Kev1n8088/CRVFCU/CRVFCU.kicad_pcb

## KiCad design CRVFCU.kicad_pcb (2025-06-09)

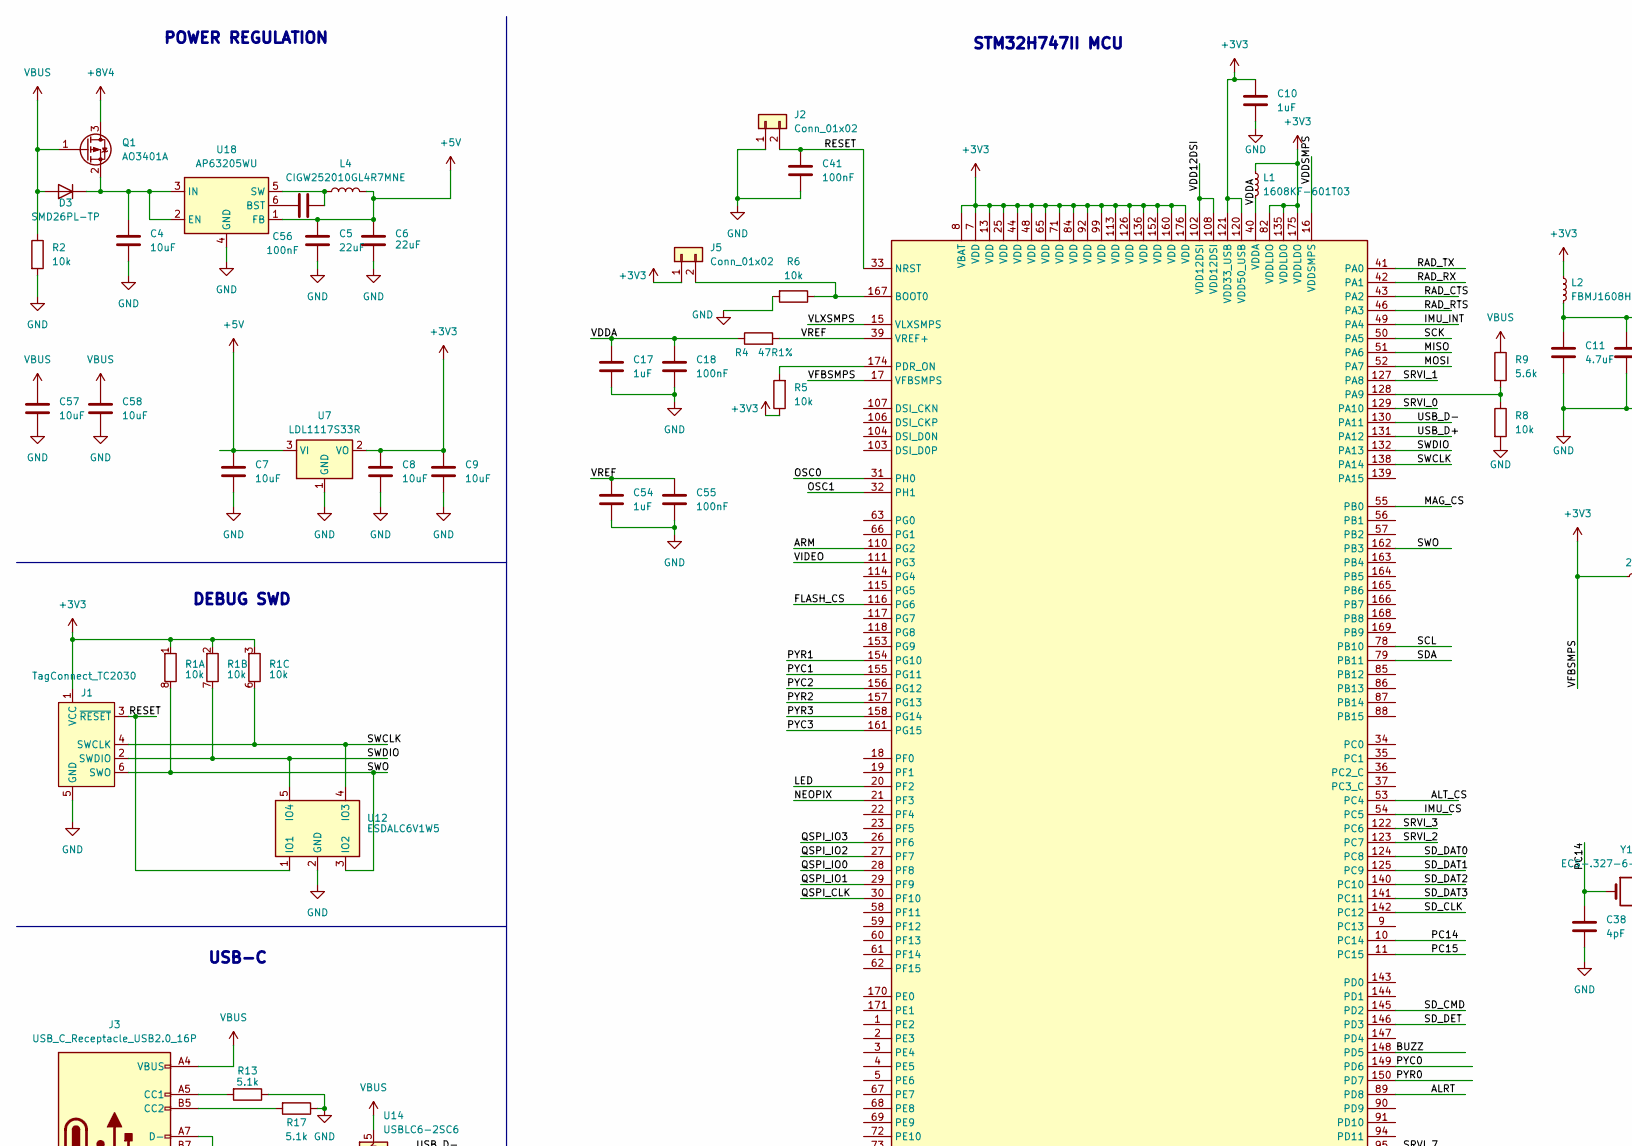
[picture p1: schematic CRVFCU.kicad_sch, CRV Components Flight Control Unit, part in row 1, column 1]

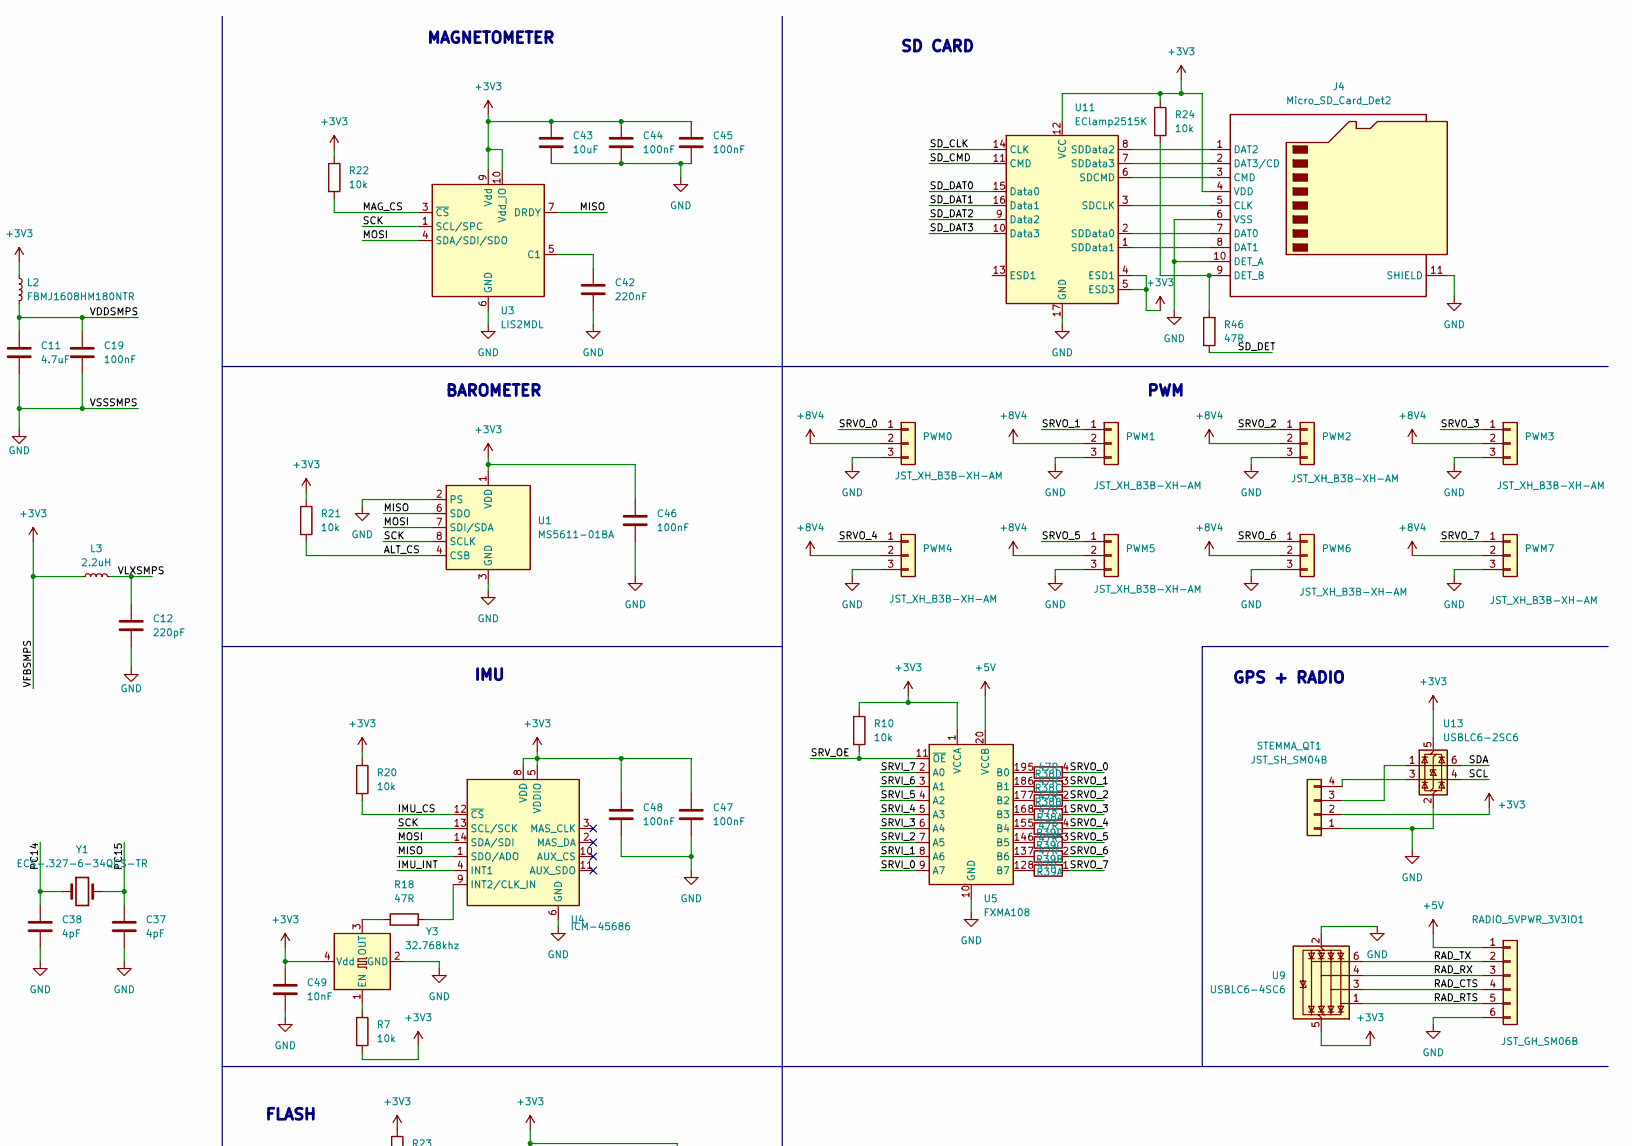
[picture p2: schematic CRVFCU.kicad_sch, CRV Components Flight Control Unit, part in row 1, column 2]

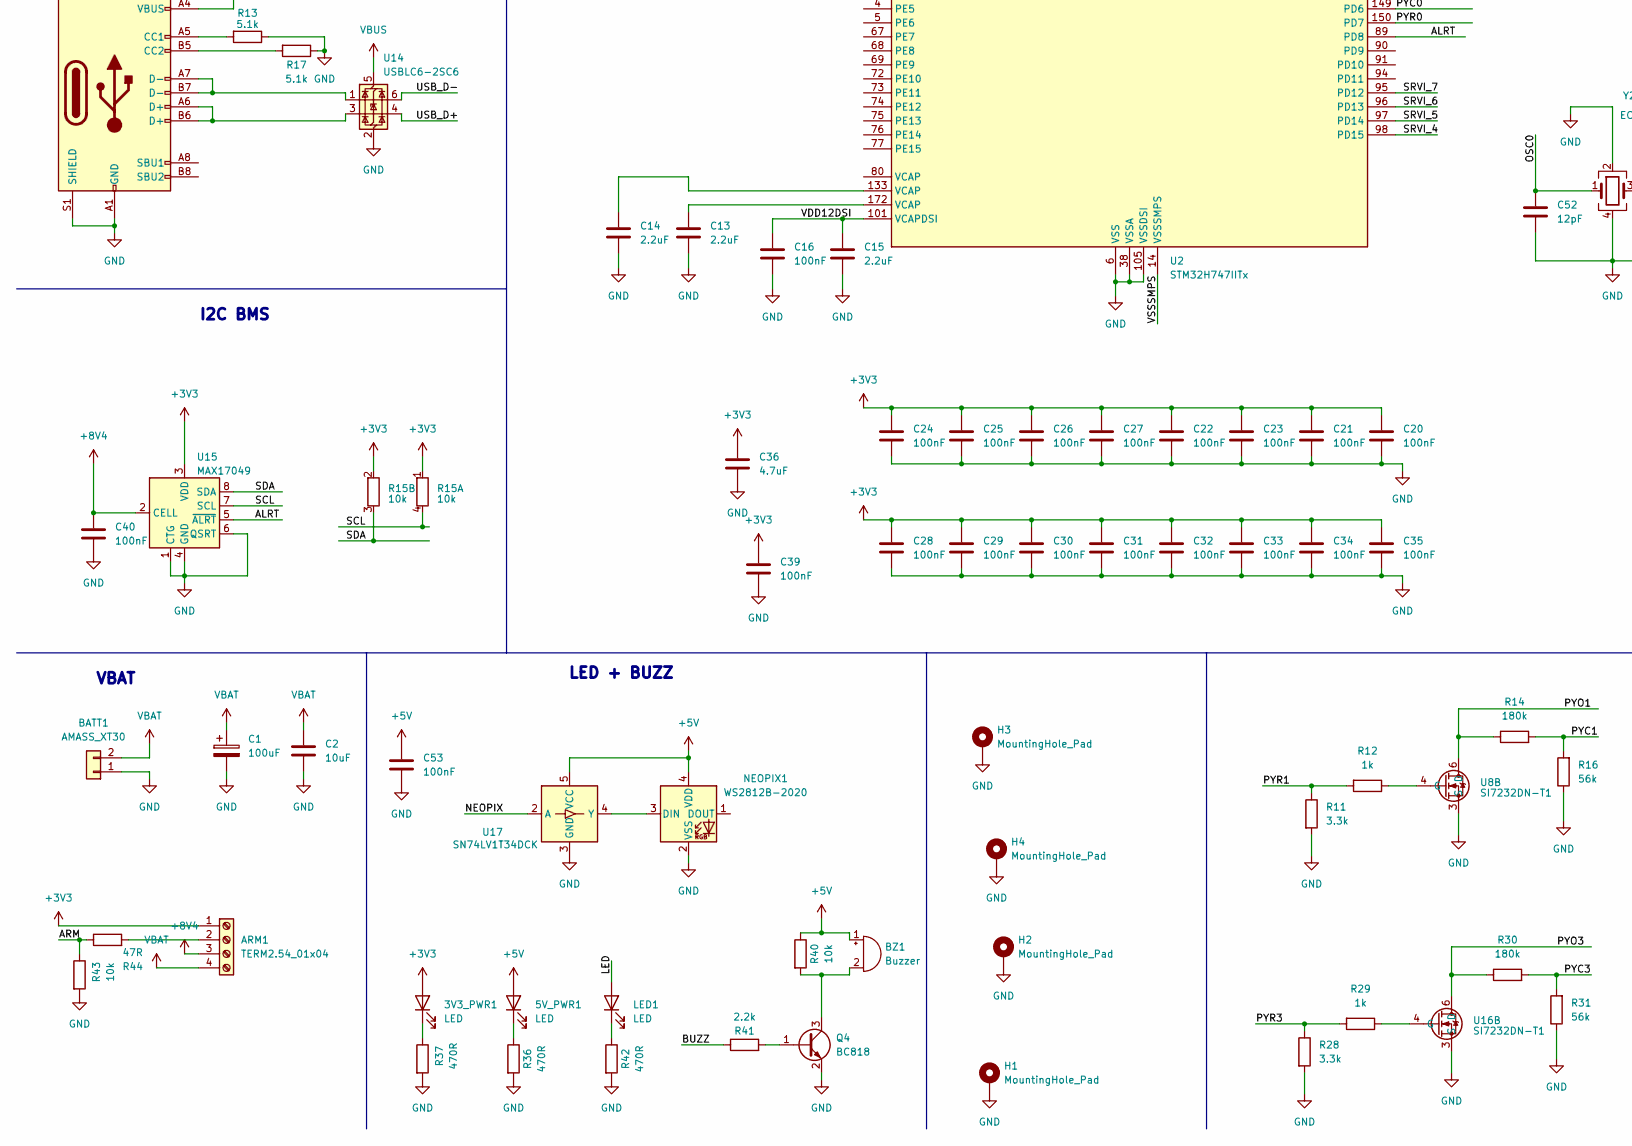
[picture p3: schematic CRVFCU.kicad_sch, CRV Components Flight Control Unit, part in row 2, column 1]

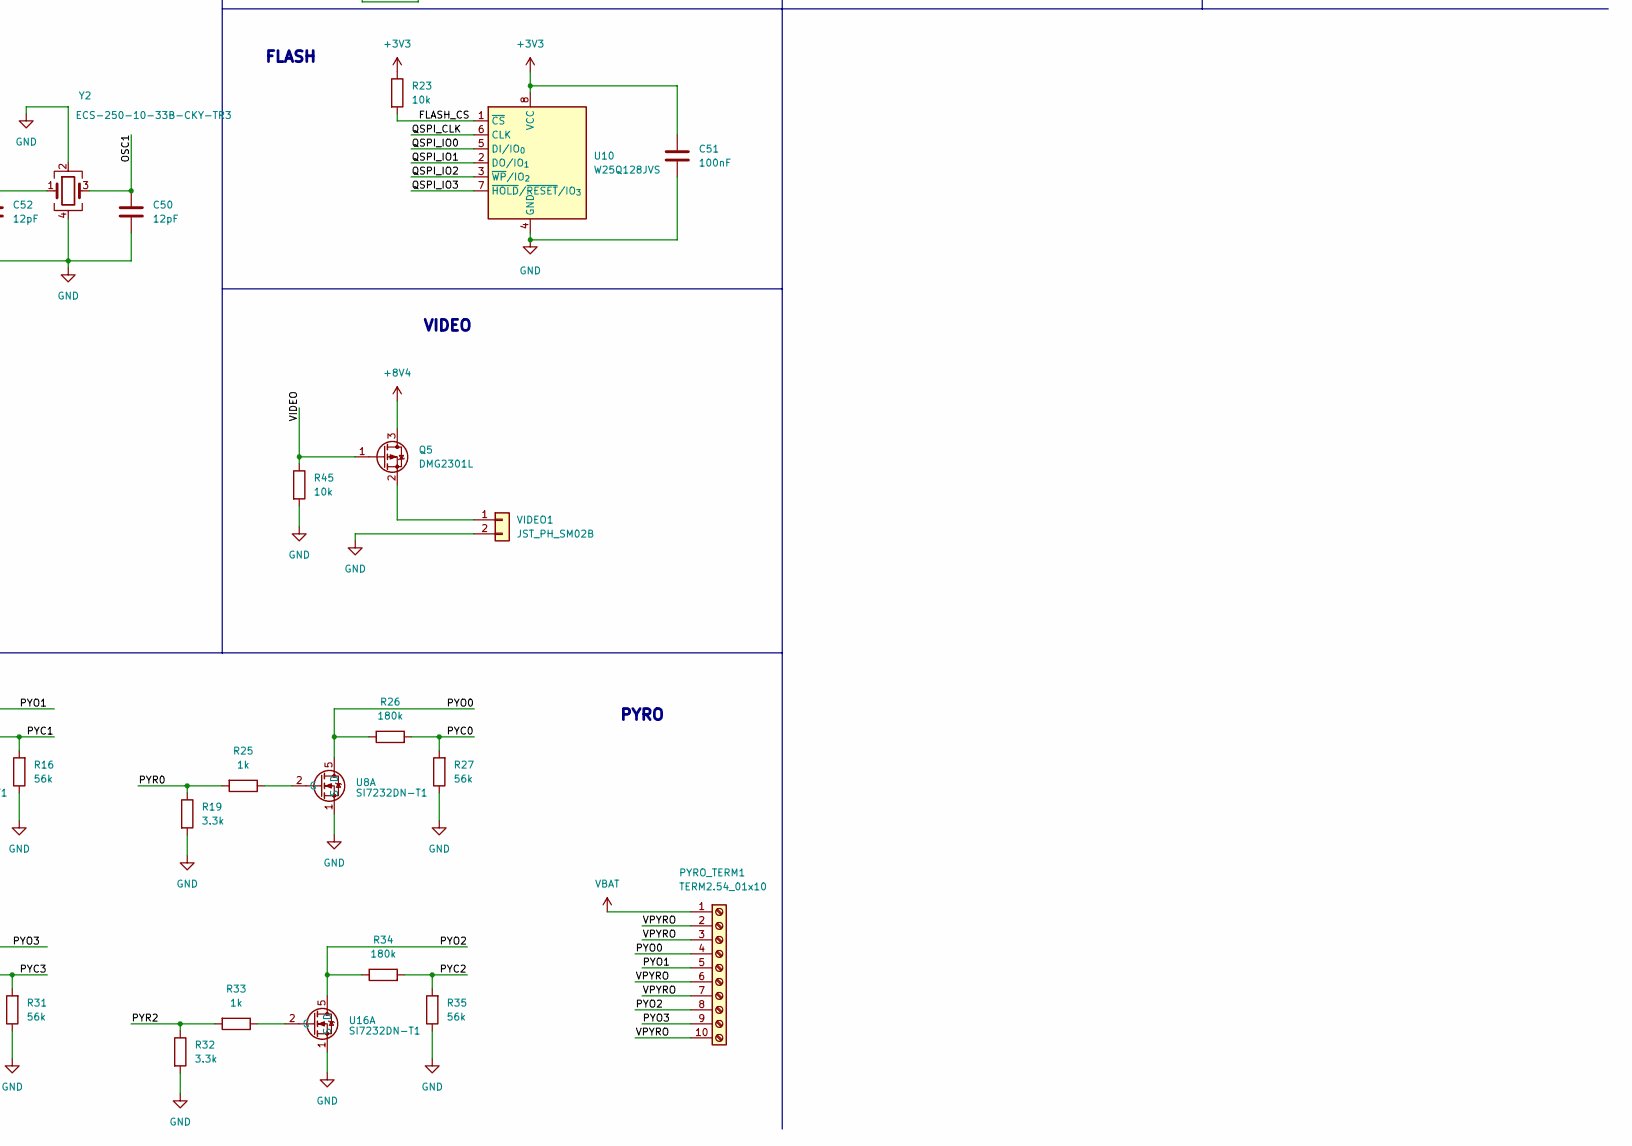
[picture p4: schematic CRVFCU.kicad_sch, CRV Components Flight Control Unit, part in row 2, column 2]

Parts:
3V3_PWR1, 5V_PWR1: LED; LED_0603_1608Metric
ARM1: TERM2.54_01x04; TerminalBlock_TE_282834-4_1x04_P2.54mm_Horizontal
BATT1: AMASS_XT30; AMASS_XT30U-F_1x02_P5.0mm_Vertical
BZ1: Buzzer; Buzzer_CUI_CPT-9019S-SMT
C1: 100uF; CP_Radial_D8.0mm_P5.00mm
C2, C4, C7, C8, C9, C43, C57, C58: 10uF; C_0402_1005Metric
C5, C6: 22uF; C_0402_1005Metric
C10, C17, C54: 1uF; C_0402_1005Metric
C11, C36: 4.7uF; C_0402_1005Metric
C12: 220pF; C_0402_1005Metric
C13, C14, C15: 2.2uF; C_0402_1005Metric
C16, C18, C19, C20, C21, C22, C23, C24, C25, C26, C27, C28, C29, C30, C31, C32, C33, C34, C35, C39, C40, C41, C44, C45, C46, C47, C48, C51, C53, C55, C56: 100nF; C_0402_1005Metric
C37, C38: 4pF; C_0402_1005Metric
C42: 220nF; C_0402_1005Metric
C49: 10nF; C_0402_1005Metric
C50, C52: 12pF; C_0402_1005Metric
D3: SMD26PL-TP; D_SOD-123F
H1, H2, H3, H4: MountingHole_Pad; MountingHole_3.2mm_M3_Pad
J1: TagConnect_TC2030; Tag-Connect_TC2030-IDC-NL_2x03_P1.27mm_Vertical
J2, J5: Conn_01x02; PinHeader_1x02_P2.54mm_Vertical
J3: USB_C_Receptacle_USB2.0_16P; USB_C_Receptacle_GCT_USB4105-xx-A_16P_TopMnt_Horizontal
J4: Micro_SD_Card_Det2; microSD_HC_Hirose_DM3AT-SF-PEJM5
L1: 1608KF-601T03; L_0603_1608Metric
L2: FBMJ1608HM180NTR; L_0603_1608Metric
L3: 2.2uH; L_0603_1608Metric
L4: CIGW252010GL4R7MNE; L_1008_2520Metric
LED1: LED; LED_0603_1608Metric
NEOPIX1: WS2812B-2020; LED_WS2812B-2020_PLCC4_2.0x2.0mm
PWM0, PWM1, PWM2, PWM3, PWM4, PWM5, PWM6, PWM7: JST_XH_B3B-XH-AM; PinHeader_1x03_P2.54mm_Vertical
PYRO_TERM1: TERM2.54_01x10; TerminalBlock_TE_1-282834-0_1x10_P2.54mm_Horizontal
Q1: AO3401A; SOT-23
Q4: BC818; SOT-23
Q5: DMG2301L; SOT-23
R1: 10k; R_Array_Convex_4x0402
R2, R5, R6, R7, R8, R10, R20, R21, R22, R23, R24, R40, R43, R45: 10k; R_0402_1005Metric
R4: 47R1%; R_0402_1005Metric
R9: 5.6k; R_0402_1005Metric
R11, R19, R28, R32: 3.3k; R_0402_1005Metric
R12, R25, R29, R33: 1k; R_0402_1005Metric
R13, R17: 5.1k; R_0402_1005Metric
R14, R26, R30, R34: 180k; R_0402_1005Metric
R15: 10k; R_Array_Convex_2x0402
R16, R27, R31, R35: 56k; R_0402_1005Metric
R18, R44, R46: 47R; R_0402_1005Metric
R36, R37, R42: 470R; R_0402_1005Metric
R38, R39: 47R; R_Array_Convex_4x0402
R41: 2.2k; R_0402_1005Metric
RADIO_5VPWR_3V3IO1: JST_GH_SM06B; JST_GH_SM06B-GHS-TB_1x06-1MP_P1.25mm_Horizontal
STEMMA_QT1: JST_SH_SM04B; JST_SH_SM04B-SRSS-TB_1x04-1MP_P1.00mm_Horizontal
U1: MS5611-01BA; LGA-8_3x5mm_P1.25mm
U2: STM32H747IITx; LQFP-176_24x24mm_P0.5mm
U3: LIS2MDL; LGA-12_2x2mm_P0.5mm
U4: ICM-45686; LGA-14_3x2.5mm_P0.5mm_LayoutBorder3x4y
U5: FXMA108; WQFN-20-1EP_2.5x4.5mm_P0.5mm_EP1x2.9mm
U7: LDL1117S33R; SOT-223-3_TabPin2
U8, U16: SI7232DN-T1; PowerPak1212-8-Dual
U9: USBLC6-4SC6; SOT-23-6
U10: W25Q128JVS; SOIC-8_5.3x5.3mm_P1.27mm
U11: EClamp2515K; OnSemi_UDFN-16-1EP_1.35x3.3mm_P0.4mm_EP0.4x2.8mm
U12: ESDALC6V1W5; SOT-353_SC-70-5
U13, U14: USBLC6-2SC6; SOT-23-6
U15: MAX17049; TDFN-8-1EP_2x2mm_P0.5mm_EP0.8x1.2mm
U17: SN74LV1T34DCK; SOT-353_SC-70-5
U18: AP63205WU; TSOT-23-6
VIDEO1: JST_PH_SM02B; JST_PH_B2B-PH-K_1x02_P2.00mm_Vertical
Y1: ECS-.327-6-34QCS-TR; Crystal_SMD_3215-2Pin_3.2x1.5mm
Y2: ECS-250-10-33B-CKY-TR3; Crystal_SMD_3225-4Pin_3.2x2.5mm
Y3: 32.768khz; Oscillator_SMD_Abracon_ASE-4Pin_3.2x2.5mm

Connections:
+3V3: 3V3_PWR1.2 (A), ARM1.1, C8.1, C9.1, C10.1, C20.1, C21.1, C22.1, C23.1, C24.1, C25.1, C26.1, C27.1, C28.1, C29.1, C30.1, C31.1, C32.1, C33.1, C34.1, C35.1, C36.1, C39.1, C43.1, C44.1, C45.1, C46.1, C47.1, C48.1, C49.1, C51.1, J1.1 (VCC), J4.4 (VDD), J5.1, L1.1, L2.1, L3.1, R1.1, R1.2, R1.3, R5.1, R7.2, R10.1, R15.1, R15.2, R20.1, R21.1, R22.1, R23.1, R24.1, STEMMA_QT1.2, U1.1 (VDD), U2.7 (VDD), U2.8 (VBAT), U2.13 (VDD), U2.17 (VFBSMPS), U2.25 (VDD), U2.44 (VDD), U2.48 (VDD), U2.65 (VDD), U2.71 (VDD), U2.82 (VDDLDO), U2.84 (VDD), U2.92 (VDD), U2.99 (VDD), U2.113 (VDD), U2.120 (VDD50_USB), U2.121 (VDD33_USB), U2.126 (VDD), U2.135 (VDDLDO), U2.136 (VDD), U2.152 (VDD), U2.160 (VDD), U2.175 (VDDLDO), U2.176 (VDD), U3.9 (Vdd), U3.10 (Vdd_IO), U4.5 (VDDIO), U4.8 (VDD), U5.1 (VCCA), U7.2 (VO), U9.5 (VBUS), U10.8 (VCC), U11.4 (ESD1), U11.5 (ESD3), U11.12 (VCC), U13.5 (VBUS), U15.3 (VDD), Y3.4 (Vdd)
+5V: 5V_PWR1.2 (A), BZ1.1 (+), C5.1, C6.1, C7.1, C53.1, L4.2, NEOPIX1.4 (VDD), R40.1, RADIO_5VPWR_3V3IO1.1, U5.20 (VCCB), U7.3 (VI), U17.5 (VCC), U18.1 (FB)
+8V4: ARM1.3, C40.1, PWM0.2, PWM1.2, PWM2.2, PWM3.2, PWM4.2, PWM5.2, PWM6.2, PWM7.2, Q1.3 (D), Q5.3 (D), U15.2 (CELL)
/ALRT: U2.89 (PD8), U15.5 (~ALRT)
/ALT_CS: R21.2, U1.4 (CSB), U1.5 (CSB), U2.53 (PC4)
/ARM: R43.1, R44.1, U2.110 (PG2)
/BUZZ: R41.1, U2.148 (PD5)
/FLASH_CS: R23.2, U2.116 (PG6), U10.1 (~CS)
/IMU_CS: R20.2, U2.54 (PC5), U4.12 (~CS)
/IMU_INT: U2.49 (PA4), U4.4 (INT1)
/LED: LED1.2 (A), U2.20 (PF2)
/MAG_CS: R22.2, U2.55 (PB0), U3.3 (~CS)
/MISO: U1.6 (SDO), U2.51 (PA6), U3.7 (DRDY), U4.1 (SDO/ADO)
/MOSI: U1.7 (SDI/SDA), U2.52 (PA7), U3.4 (SDA/SDI/SDO), U4.14 (SDA/SDI)
/NEOPIX: U2.21 (PF3), U17.2 (A)
/OSC0: C52.1, U2.31 (PH0), Y2.1
/OSC1: C50.1, U2.32 (PH1), Y2.3
/PC14: C38.1, U2.10 (PC14), Y1.1
/PC15: C37.1, U2.11 (PC15), Y1.2
/PYC0: R26.2, R27.2, U2.149 (PD6)
/PYC1: R14.2, R16.2, U2.155 (PG11)
/PYC2: R34.2, R35.2, U2.156 (PG12)
/PYC3: R30.2, R31.2, U2.161 (PG15)
/PYO0: PYRO_TERM1.4, R26.1, U8.5 (D)
/PYO1: PYRO_TERM1.5, R14.1, U8.6 (D)
/PYO2: PYRO_TERM1.8, R34.1, U16.5 (D)
/PYO3: PYRO_TERM1.9, R30.1, U16.6 (D)
/PYR0: R19.1, R25.2, U2.150 (PD7)
/PYR1: R11.1, R12.2, U2.154 (PG10)
/PYR2: R32.1, R33.2, U2.157 (PG13)
/PYR3: R28.1, R29.2, U2.158 (PG14)
/QSPI_CLK: U2.30 (PF10), U10.6 (CLK)
/QSPI_IO0: U2.28 (PF8), U10.5 (DI/IO_{0})
/QSPI_IO1: U2.29 (PF9), U10.2 (DO/IO_{1})
/QSPI_IO2: U2.27 (PF7), U10.3 (~WP/IO_{2})
/QSPI_IO3: U2.26 (PF6), U10.7 (~HOLD/~RESET/IO_{3})
/RAD_CTS: RADIO_5VPWR_3V3IO1.4, U2.43 (PA2), U9.3 (I/O2)
/RAD_RTS: RADIO_5VPWR_3V3IO1.5, U2.46 (PA3), U9.1 (I/O1)
/RAD_RX: RADIO_5VPWR_3V3IO1.3, U2.42 (PA1), U9.4 (I/O3)
/RAD_TX: RADIO_5VPWR_3V3IO1.2, U2.41 (PA0), U9.6 (I/O4)
/RESET: C41.2, J1.3 (~RESET), J2.2, U2.33 (NRST), U12.1 (IO1)
/SCK: U1.8 (SCLK), U2.50 (PA5), U3.1 (SCL/SPC), U4.13 (SCL/SCK)
/SCL: R15.4, U2.78 (PB10), U13.4 (I/O2), U15.7 (SCL)
/SDA: R15.3, U2.79 (PB11), U13.6 (I/O1), U15.8 (SDA)
/SD_CLK: U2.142 (PC12), U11.14 (CLK)
/SD_CMD: U2.145 (PD2), U11.11 (CMD)
/SD_DAT0: U2.124 (PC8), U11.15 (Data0)
/SD_DAT1: U2.125 (PC9), U11.16 (Data1)
/SD_DAT2: U2.140 (PC10), U11.9 (Data2)
/SD_DAT3: U2.141 (PC11), U11.10 (Data3)
/SD_DET: R46.1, U2.146 (PD3)
/SRVI_0: U2.129 (PA10), U5.9 (A7)
/SRVI_1: U2.127 (PA8), U5.8 (A6)
/SRVI_2: U2.123 (PC7), U5.7 (A5)
/SRVI_3: U2.122 (PC6), U5.6 (A4)
/SRVI_4: U2.98 (PD15), U5.5 (A3)
/SRVI_5: U2.97 (PD14), U5.4 (A2)
/SRVI_6: U2.96 (PD13), U5.3 (A1)
/SRVI_7: U2.95 (PD12), U5.2 (A0)
/SRVO_0: PWM0.1, R38.4
/SRVO_1: PWM1.1, R38.3
/SRVO_2: PWM2.1, R38.2
/SRVO_3: PWM3.1, R38.1
/SRVO_4: PWM4.1, R39.4
/SRVO_5: PWM5.1, R39.3
/SRVO_6: PWM6.1, R39.2
/SRVO_7: PWM7.1, R39.1
/SRV_OE: R10.2, U5.11 (~OE)
/SWCLK: J1.4 (SWCLK), R1.6, U2.138 (PA14), U12.4 (IO3)
/SWDIO: J1.2 (SWDIO), R1.7, U2.132 (PA13), U12.5 (IO4)
/SWO: J1.6 (SWO), R1.8, U2.162 (PB3), U12.3 (IO2)
/USB_D+: U2.131 (PA12), U14.4 (I/O2)
/USB_D-: U2.130 (PA11), U14.6 (I/O1)
/VDD12DSI: C15.1, C16.1, U2.101 (VCAPDSI), U2.102 (VDD12DSI), U2.108 (VDD12DSI)
/VDDA: C17.1, C18.1, L1.2, R4.1, U2.40 (VDDA)
/VDDSMPS: C11.1, C19.1, L2.2, U2.16 (VDDSMPS)
/VIDEO: Q5.1 (G), R45.1, U2.111 (PG3)
/VLXSMPS: C12.2, L3.2, U2.15 (VLXSMPS)
/VPYRO: PYRO_TERM1.2, PYRO_TERM1.3, PYRO_TERM1.6, PYRO_TERM1.7, PYRO_TERM1.10
/VREF: C54.1, C55.1, R4.2, U2.39 (VREF+)
GND: BATT1.1, C1.2, C2.2, C4.2, C5.2, C6.2, C7.2, C8.2, C9.2, C10.2, C11.2, C12.1, C13.2, C14.2, C15.2, C16.2, C17.2, C18.2, C19.2, C20.2, C21.2, C22.2, C23.2, C24.2, C25.2, C26.2, C27.2, C28.2, C29.2, C30.2, C31.2, C32.2, C33.2, C34.2, C35.2, C36.2, C37.2, C38.2, C39.2, C40.2, C41.1, C42.2, C43.2, C44.2, C45.2, C46.2, C47.2, C48.2, C49.2, C50.2, C51.2, C52.2, C53.2, C54.2, C55.2, C57.2, C58.2, H1.1, H2.1, H3.1, H4.1, J1.5 (GND), J2.1, J3.A1 (GND), J3.A12 (GND), J3.B1 (GND), J3.B12 (GND), J3.S1 (SHIELD), J4.6 (VSS), J4.10 (DET_A), J4.11 (SHIELD), NEOPIX1.2 (VSS), PWM0.3, PWM1.3, PWM2.3, PWM3.3, PWM4.3, PWM5.3, PWM6.3, PWM7.3, Q4.2 (E), R2.2, R6.2, R8.2, R11.2, R13.1, R16.1, R17.1, R19.2, R27.1, R28.2, R31.1, R32.2, R35.1, R36.2, R37.2, R42.2, R43.2, R45.2, RADIO_5VPWR_3V3IO1.6, STEMMA_QT1.1, U1.2 (PS), U1.3 (GND), U2.6 (VSS), U2.12 (VSS), U2.14 (VSSSMPS), U2.24 (VSS), U2.38 (VSSA), U2.45 (VSS), U2.47 (VSS), U2.64 (VSS), U2.70 (VSS), U2.81 (VSS), U2.83 (VSS), U2.93 (VSS), U2.100 (VSS), U2.105 (VSSDSI), U2.109 (VSSDSI), U2.112 (VSS), U2.119 (VSS), U2.134 (VSS), U2.137 (VSS), U2.151 (VSS), U2.159 (VSS), U2.173 (VSS), U3.6 (GND), U3.8 (GND), U4.6 (GND), U5.10 (GND), U7.1 (GND), U8.1 (S), U8.3 (S), U9.2 (GND), U10.4 (GND), U11.17 (GND), U12.2 (GND), U13.2 (GND), U14.2 (GND), U15.1 (CTG), U15.4 (GND), U15.6 (QSRT), U16.1 (S), U16.3 (S), U17.3 (GND), U18.4 (GND), VIDEO1.2, Y2.2, Y2.4, Y3.2 (GND)
unnamed: 3V3_PWR1.1 (K), R37.1
unnamed: 5V_PWR1.1 (K), R36.1
unnamed: ARM1.2, R44.2
unnamed: BZ1.2 (-), Q4.3 (C), R40.2
unnamed: C13.1, U2.172 (VCAP)
unnamed: C14.1, U2.133 (VCAP)
unnamed: C4.1, D3.1 (K), Q1.2 (S), U18.2 (EN), U18.3 (IN)
unnamed: J3.A5 (CC1), R13.2
unnamed: J3.B5 (CC2), R17.2
unnamed: J3.A6 (D+), J3.B6 (D+), U14.3 (I/O2)
unnamed: J3.A7 (D-), J3.B7 (D-), U14.1 (I/O1)
unnamed: J4.5 (CLK), U11.3 (SDCLK)
unnamed: J4.3 (CMD), U11.6 (SDCMD)
unnamed: J4.7 (DAT0), U11.2 (SDData0)
unnamed: J4.8 (DAT1), U11.1 (SDData1)
unnamed: J4.1 (DAT2), U11.8 (SDData2)
unnamed: J4.2 (DAT3/CD), U11.7 (SDData3)
unnamed: J4.9 (DET_B), R24.2, R46.2
unnamed: J5.2, R6.1, U2.167 (BOOT0)
unnamed: LED1.1 (K), R42.1
unnamed: NEOPIX1.3 (DIN), U17.4 (Y)
unnamed: Q4.1 (B), R41.2
unnamed: Q5.2 (S), VIDEO1.1
unnamed: STEMMA_QT1.3, U13.1 (I/O1)
unnamed: STEMMA_QT1.4, U13.3 (I/O2)
unnamed: R8.1, R9.2, U2.128 (PA9)
unnamed: R5.2, U2.174 (PDR_ON)
unnamed: C42.1, U3.5 (C1)
unnamed: R18.2, U4.9 (INT2/CLK_IN)
unnamed: R38.5, U5.19 (B0)
unnamed: R38.6, U5.18 (B1)
unnamed: R38.7, U5.17 (B2)
unnamed: R38.8, U5.16 (B3)
unnamed: R39.5, U5.15 (B4)
unnamed: R39.6, U5.14 (B5)
unnamed: R39.7, U5.13 (B6)
unnamed: R39.8, U5.12 (B7)
unnamed: R25.1, U8.2 (G)
unnamed: R12.1, U8.4 (G)
unnamed: R33.1, U16.2 (G)
unnamed: R29.1, U16.4 (G)
unnamed: C56.1, U18.6 (BST)
unnamed: C56.2, L4.1, U18.5 (SW)
unnamed: R7.1, Y3.1 (EN)
unnamed: R18.1, Y3.3 (OUT)
VBAT: ARM1.4, BATT1.2, C1.1, C2.1, PYRO_TERM1.1
VBUS: C57.1, C58.1, D3.2 (A), J3.A4 (VBUS), J3.A9 (VBUS), J3.B4 (VBUS), J3.B9 (VBUS), Q1.1 (G), R2.1, R9.1, U14.5 (VBUS)

Notes on the sheet:
STM32H747II MCU
PYRO
IMU
PWM
GPS + RADIO
VIDEO
I2C BMS
DEBUG SWD
MAGNETOMETER
BAROMETER
SD CARD
FLASH
VBAT
USB-C
LED + BUZZ
POWER REGULATION

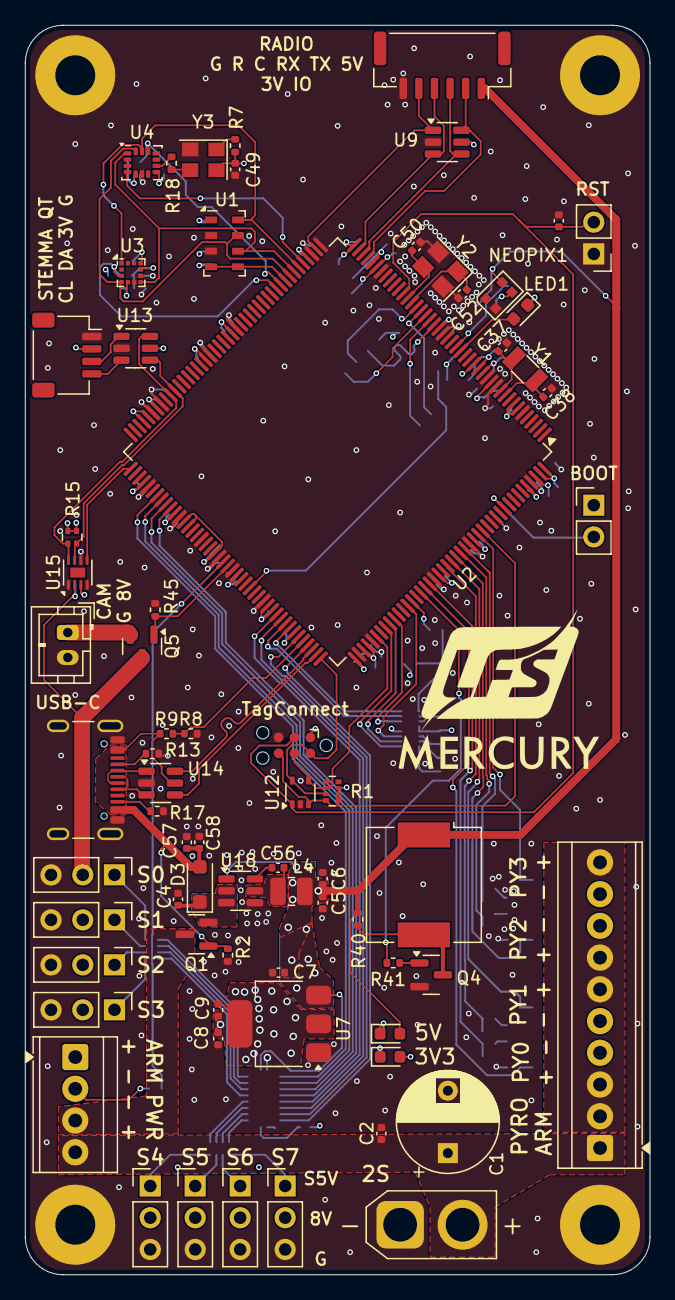
[picture p5: board CRVFCU.kicad_pcb from above]

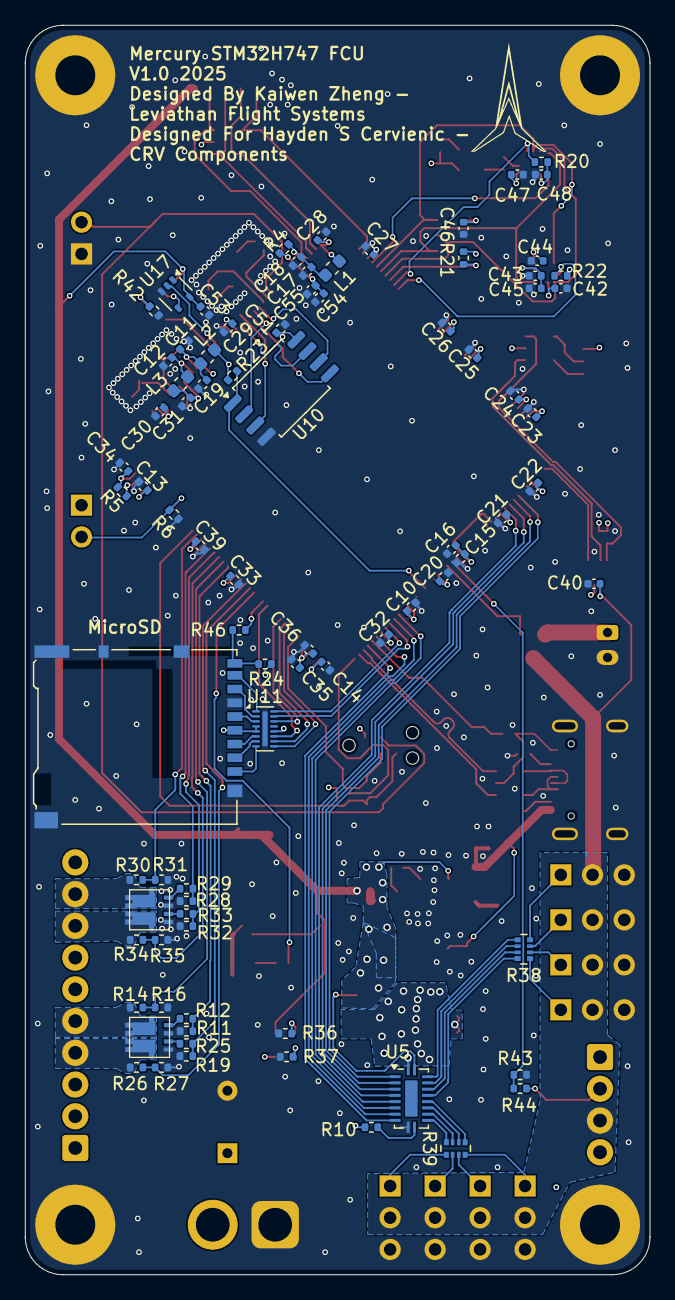
[picture p6: board CRVFCU.kicad_pcb from below]

Board: 4 copper layers, 50.0 x 100.0 mm, 158 parts (83 on the bottom side), 128 nets.
