Kev1n8088/CRVFCU/(commit log)

2025-05-09 parts of initial schematic completed
    [CRVFCU.kicad_pcb, CRVFCU.kicad_sch]
2025-05-10 completed grouping in pcb, prep for route
    [CRVFCU.kicad_pcb]
2025-05-11 completed 50x100 routing, attempting 40mm
    [CRVFCU.kicad_pcb, CRVFCU.kicad_sch]
2025-05-11 added bom and changed 25mhz oscillator
    [BOM-CRVFCU.csv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]
2025-05-11 rounded corners, added silkscreens, fixed 25mhz oscillator, missing logos but basically finalized
    [CRVFCU.kicad_pcb, CRVFCU.kicad_sch]
2025-05-11 changed rst and boot to headers
    [CRVFCU.kicad_pcb, CRVFCU.kicad_sch]
2025-05-11 changed some small layout items and fixed drc
    [CRVFCU.kicad_pcb]
2025-05-11 made oscillator vias more standardized
    [CRVFCU.kicad_pcb]
2025-05-12 added vref caps and changed some cap values
    [CRVFCU.kicad_pcb, CRVFCU.kicad_sch]
2025-05-12 adjusted crystals
    [CRVFCU.kicad_sch]
2025-05-12 added silkscreens
    [CRVFCU.kicad_pcb]
2025-05-12 tuned silkscreens
    [CRVFCU.kicad_pcb]
2025-05-12 fixed drc silkscreens
    [CRVFCU.kicad_pcb]
2025-05-12 some more silkscreen changes
    [CRVFCU.kicad_pcb]
2025-05-12 changed silkscreens and via locations for aesthetics
    [CRVFCU.kicad_pcb]
2025-05-12 changed via sizes for manufacturing purposes and fixed drc
    [CRVFCU.kicad_pcb]
2025-05-12 changed hole clearance to 0.2mm and resolved drc
    [CRVFCU.kicad_pcb]
2025-05-12 changed edge clearance to 0.2mm
    [CRVFCU.kicad_pcb]
2025-05-13 changed constraints to allow for manufacturing by oshpark, drc resolved
    [CRVFCU-B_Cu.gbr, CRVFCU-B_Mask.gbr, CRVFCU-B_Paste.gbr, CRVFCU-B_Silkscreen.gbr, CRVFCU-Edge_Cuts.gbr, CRVFCU-F_Cu.gbr, CRVFCU-F_Mask.gbr, CRVFCU-F_Paste.gbr]
2025-05-13 changed color and adjusted some traces
    [CRVFCU.kicad_pcb]
2025-05-13 adjusted some vias
    [CRVFCU-B_Cu.gbr, CRVFCU-B_Mask.gbr, CRVFCU-B_Paste.gbr, CRVFCU-B_Silkscreen.gbr, CRVFCU-Edge_Cuts.gbr, CRVFCU-F_Cu.gbr, CRVFCU-F_Mask.gbr, CRVFCU-F_Paste.gbr]
2025-05-13 added IMU directional indicator
    [CRVFCU.kicad_pcb]
2025-05-13 added some vias
    [CRVFCU.kicad_pcb]
2025-05-13 changed silkscreen slightly
    [CRVFCU.kicad_pcb]
2025-05-26 ensured all servo pins are PWM capable, and changed 5v LDO to buck
    [CRVFCU.kicad_pcb, CRVFCU.kicad_sch]
2025-05-26 added protection diode for buck and changed routing for thermal considerations
    [CRVFCU.kicad_pcb, CRVFCU.kicad_sch]
2025-05-26 changed to higher current mosfet for power supply switching and fixed silkscreens
    [CRVFCU.kicad_pcb, CRVFCU.kicad_sch]
2025-05-27 simplified power delivery
    [CRVFCU.kicad_pcb, CRVFCU.kicad_sch]
2025-05-28 adjusted usbc port and 5v pour dimensions
    [CRVFCU.kicad_pcb]
2025-06-09 added XYZ orientation sign
    [CRVFCU.kicad_pcb]
2025-06-09 changed cam to jst ph
    [CRVFCU.kicad_pcb, CRVFCU.kicad_sch]
